ImperialSpaceSociety/Cansat-2020-team-1/README.md

# Cansat-2020-team-1
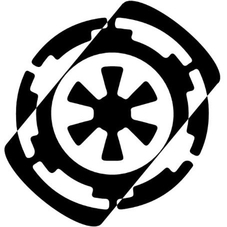
[picture p1: Media/team image.jpg]
Team_Logo

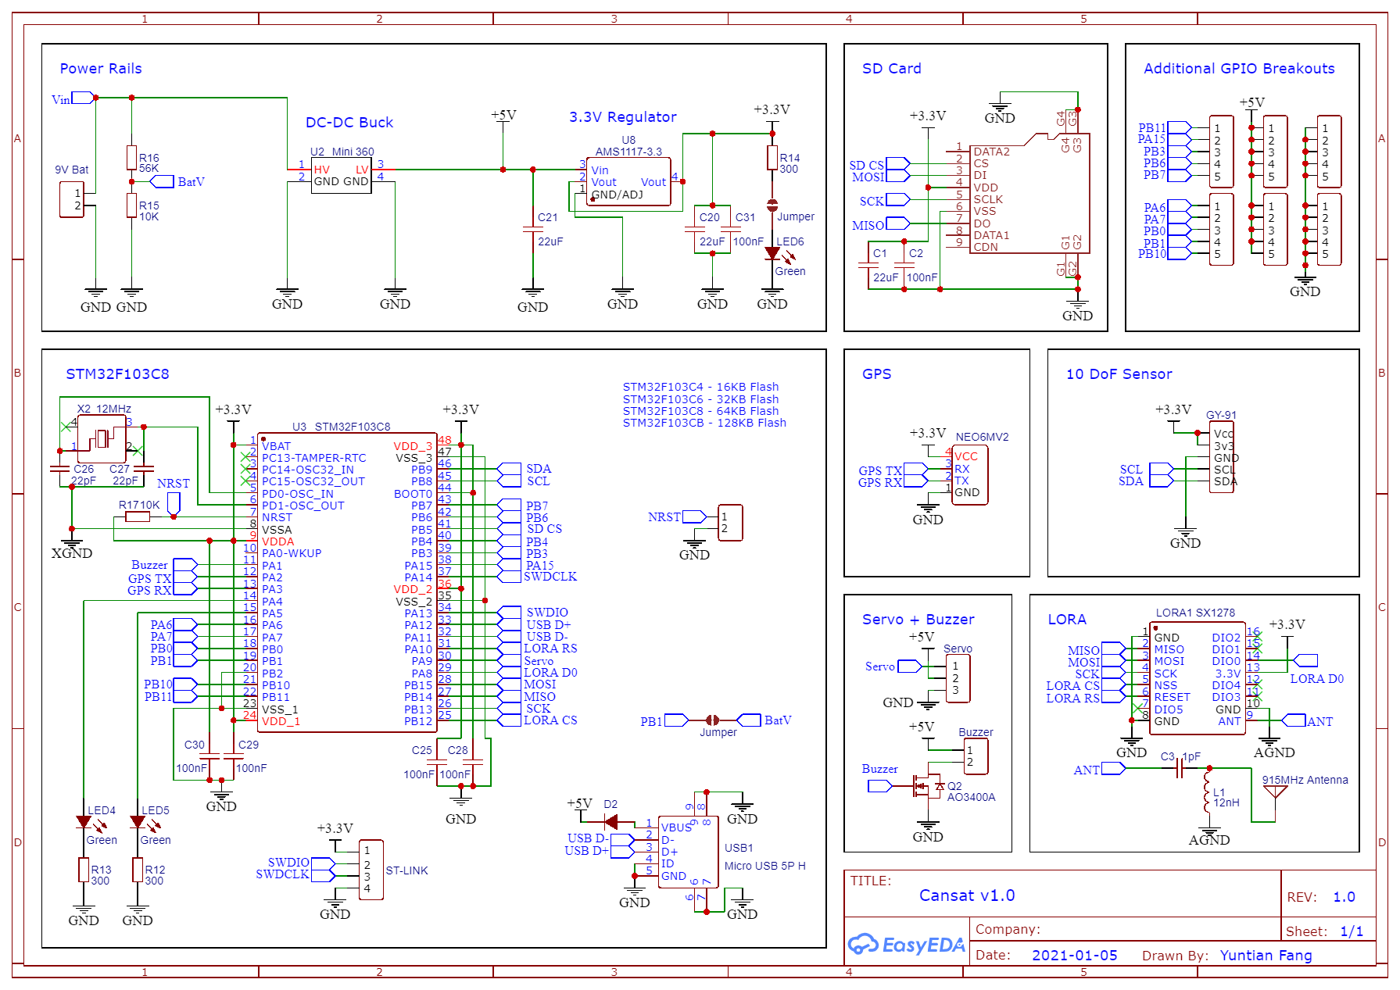
[picture p2: Cansat PCB Files/Cansat Controller.png]
Cansat_Controller_Schematic

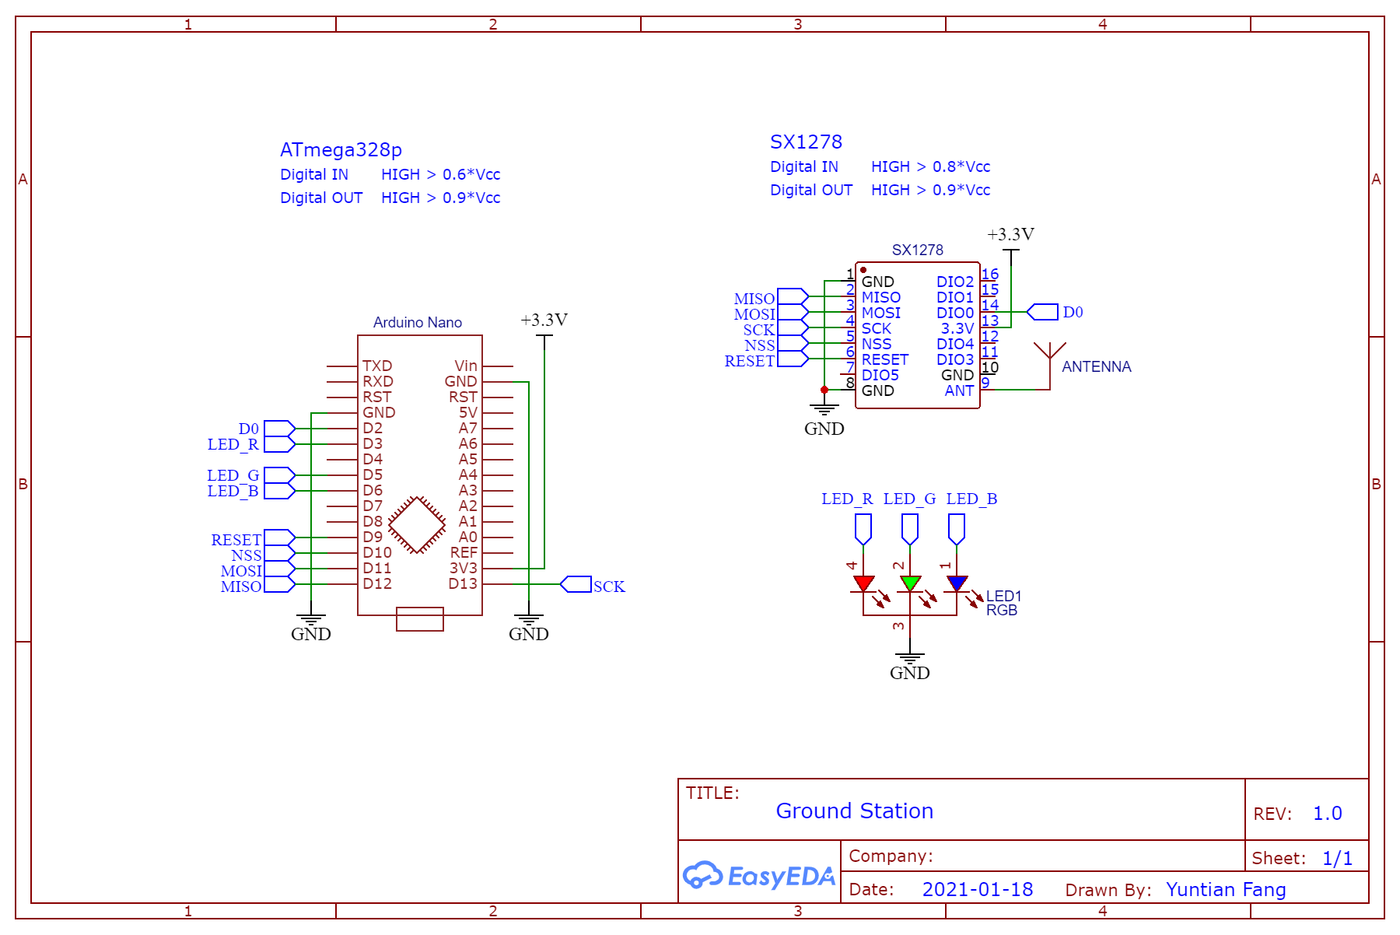
[picture p3: Cansat PCB Files/Ground station.png]
Ground_Station_Schematic


EasyEDA project can be found at:
https://oshwlab.com/tfang15532/2020-cansat
