ImperialSpaceSociety/Cansat-2020-team-1/Cansat PCB Files/PCB Back.png

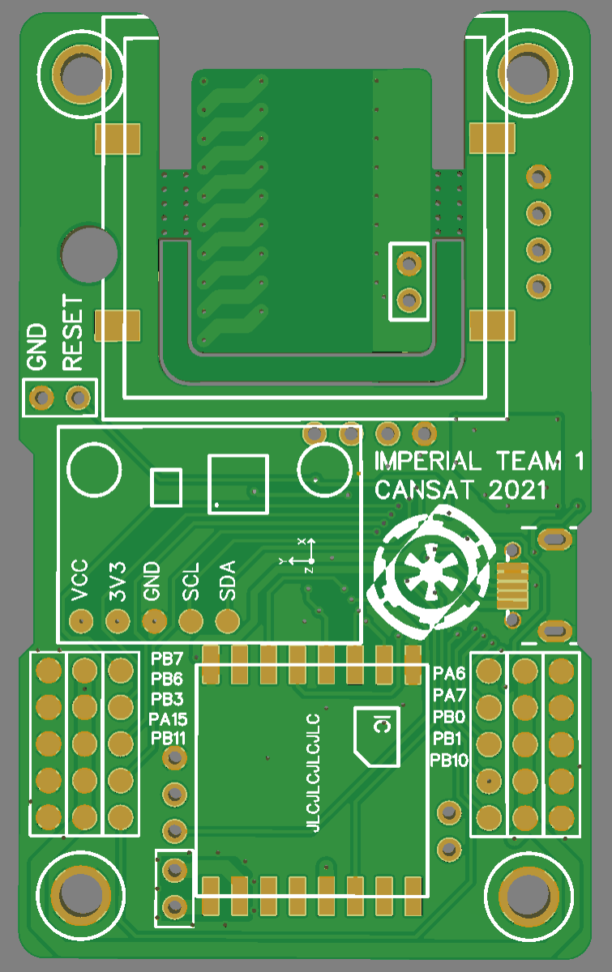
Cansat PCB Files/PCB Back.png
