ImperialSpaceSociety/Cansat-2020-team-1/Cansat PCB Files/PCB Front.png

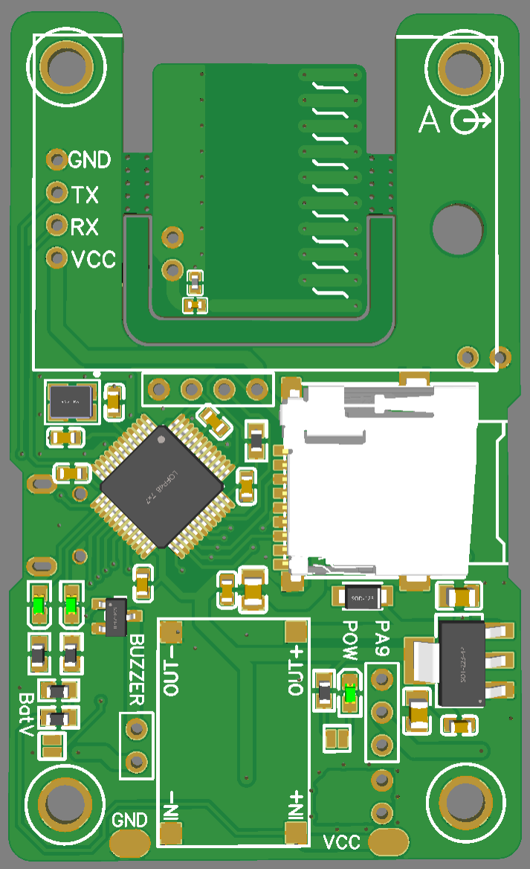
Cansat PCB Files/PCB Front.png
