ImperialSpaceSociety/Cansat-2020-team-1/Media/CanSat Code.png

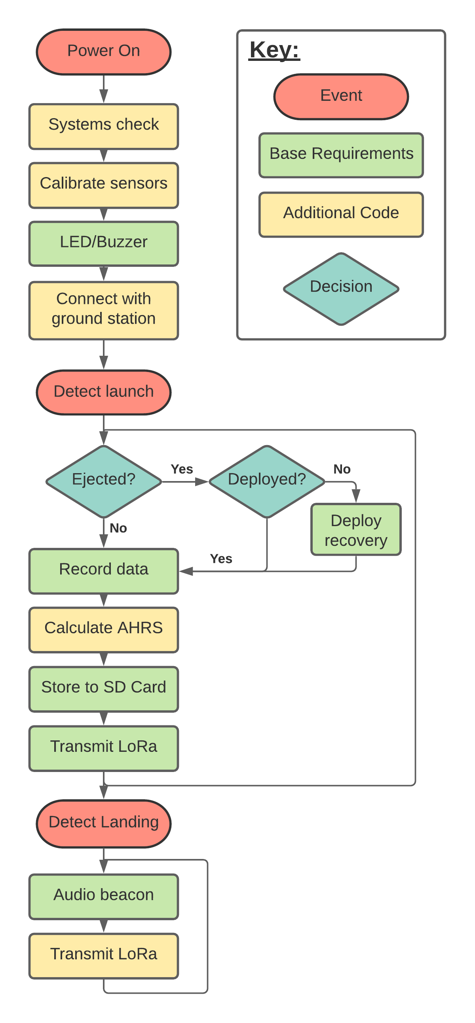
Media/CanSat Code.png
