ImperialSpaceSociety/Cansat-2020-team-1/Media/Cansat Power.png

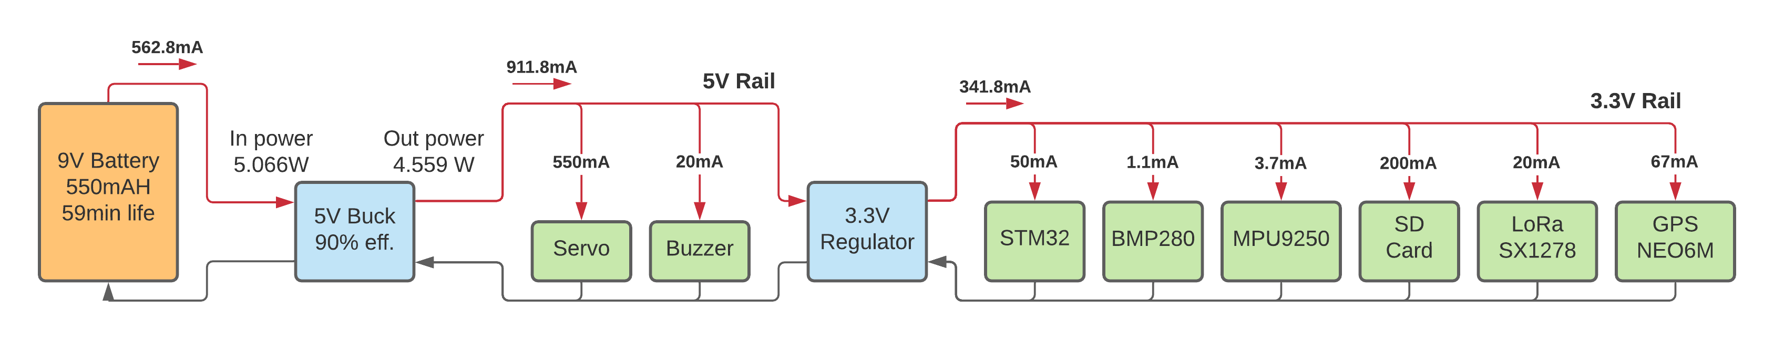
Media/Cansat Power.png
