ImperialSpaceSociety/Cansat-2020-team-1/Media/Madgwick Filter.png

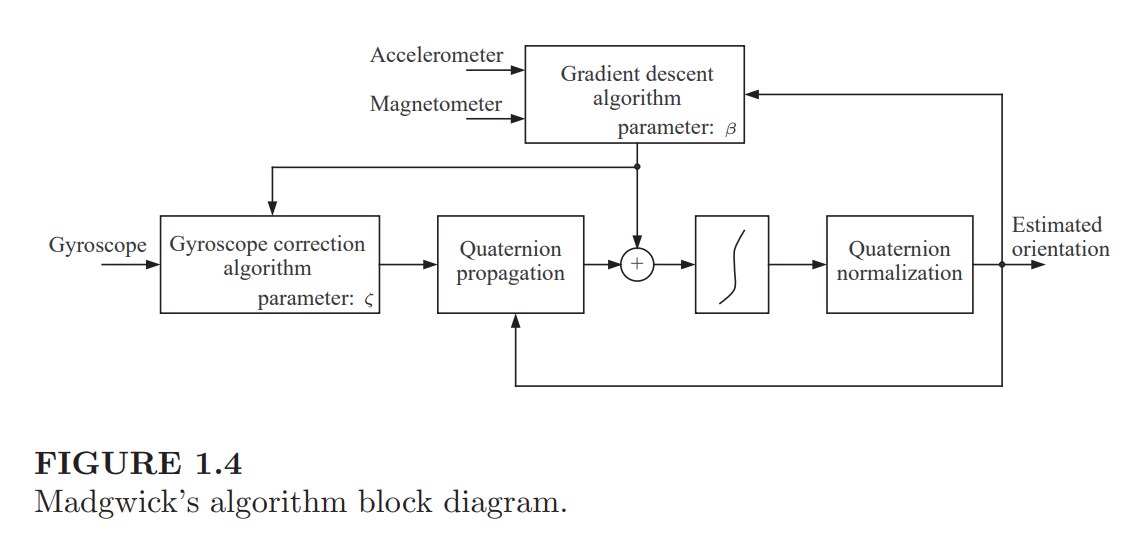
Media/Madgwick Filter.png
