ImperialSpaceSociety/Cansat-2020-team-1/Media/Mahony Filter.png

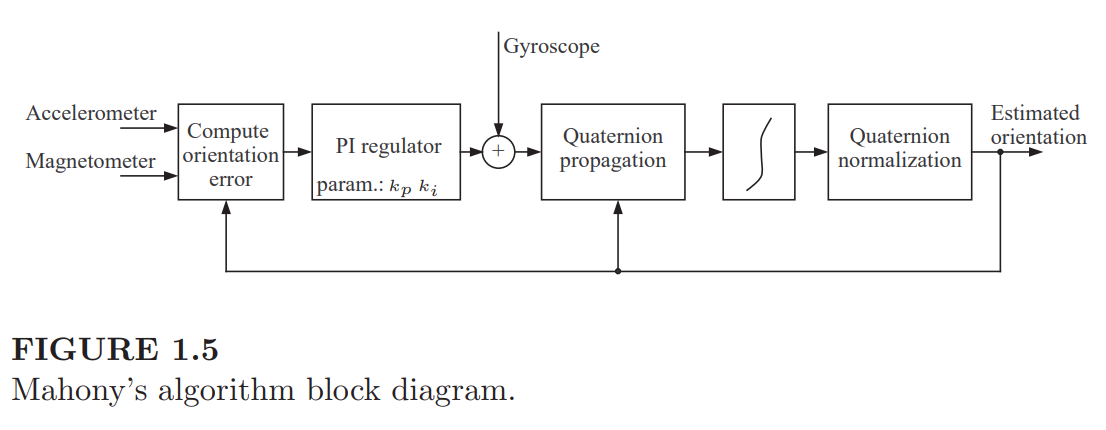
Media/Mahony Filter.png
