ImperialSpaceSociety/Cansat-2020-team-1/Cansat PCB Files/BOM_ICLR - Cansat Controller 2021_2021-01-20.csv

ID | Name | Designator | Footprint | Quantity | Manufacturer Part | Manufacturer | Supplier | Supplier Part | JLCPCB SMD | LCSC Assembly
1 | 22pF | C26,C27 | C0603 | 2 | CL10C220JB8NNNC | SAMSUNG | LCSC | C1653 | Yes
2 | Micro usb | U1 | MICRO USB | 1
3 | 12MHz | X2 | OSC-SMD_4P-L3.2-W2.5-BL | 1 | X322512MSB4SI | YXC | LCSC | C9002 | Yes
4 | Mini 360 | U2 | MINI 360 | 1
5 | 22uF | C20,C21,C1 | C0805 | 3 | CL21A226MAQNNNE | SAMSUNG | LCSC | C45783 | Yes
6 | 12nH | L1 | L0402 | 1 | SDCL1005C12NJTDF | Sunlord | LCSC | C24563 | Yes | Yes
7 | SX1278 | LORA1 | SX1278 | 1 |  |  | eBay
8 | 100nF | C25,C28,C29,C30,C31,C2 | C0603 | 6 | CC0603KRX7R9BB104 | YAGEO | LCSC | C14663 | Yes
9 | Green | LED4,LED5,LED6 | LED0603-R-RD | 3 | 19-217/GHC-YR1S2/3T | EVERLIGHT | LCSC | C72043 | Yes
10 | 56K | R16 | R0603 | 1 | 0603WAF5602T5E | UniOhm | LCSC | C23206 | Yes
11 | AMS1117-3.3 | U8 | SOT-223-3_L6.5-W3.4-P2.30-LS7.0-BR | 1 | AMS1117-3.3 | AMS | LCSC | C6186 | Yes
12 | STM32F103C8 | U3 | LQFP-48_L7.0-W7.0-P0.50-LS9.0-BL | 1 | STM32F103CBT6 | STMicroelectronics | LCSC | C8304
13 | ANTENNA | ANT1 | ANTENNA | 1
14 | Micro SD Card Holder; | J1 | SD CARD | 1 | ?
15 | Jumper | SJ2,SJ1 | PAD-JUMPER-2-NO_NO_SILK | 2
16 | HDR-M-2.54_1x5 | J2,J3,J4,J5,J6,J7 | HDR-M-2.54_1X5 | 6 |  |  | LCSC | C358687
17 | HDR-M-2.54_1x5 | GY-91 | GY-91 MODIFIED | 1 |  |  | LCSC | C358687
18 | 10K | R15,R17 | R0603 | 2 | 0603WAF1002T5E | UniOhm | LCSC | C25804 | Yes
19 | 300 | R12,R13,R14 | R0603 | 3 | 0603WAF3000T5E | UniOhm | LCSC | C23025 | Yes
20 | NEO6MV2 | U9 | GY-NEO6MV2 | 1 |  |  | eBay
21 | 1pF | C3 | C0402 | 1 | 0402CG1R0C500NT | FH | LCSC | C1550 | Yes | Yes
22 | B5819W_C8598 | D2 | SOD-123_L2.8-W1.8-LS3.7-RD | 1 | B5819W | CJ | LCSC | C8598 | Yes
23 | AO3400A | Q2 | SOT-23-3_L2.9-W1.6-P1.90-LS2.8-BR | 1 | AO3400A | AOS | LCSC | C20917 | Yes
