ImperialSpaceSociety/Cansat-2020-team-1/Media/Data Handling.xlsx

Sheet: Signal Strength
f/MHz | 868 | datasheet: | https://cdn-shop.adafruit.com/product-files/3179/sx1276_77_78_79.pdf
 |  |  | Path loss
 | TX Strength | Antenna (worst case) | 0 | 20 | 40 | 60 | 80 | 100 | 120 | 140 | 160 | 180 | 200 | 220 | 240 | 260 | 280 | 300 | 320 | 340 | 360 | 380 | 400 | Antenna | RX
dB change |  | -12 | 0 | 57.24099442 | 63.26159433 | 66.78341951 | 69.28219424 | 71.2203945 | 72.80401942 | 74.14295522 | 75.30279416 | 76.32584461 | 77.24099442 | 78.06884812 | 78.82461934 | 79.51986146 | 80.16355513 | 80.7628196 | 81.32339407 | 81.84997284 | 82.34644452 | 82.81606644 | 83.26159433 | -6
Signal dB Strength | 7 | -5 | -5 | -62.24099442 | -68.26159433 | -71.78341951 | -74.28219424 | -76.2203945 | -77.80401942 | -79.14295522 | -80.30279416 | -81.32584461 | -82.24099442 | -83.06884812 | -83.82461934 | -84.51986146 | -85.16355513 | -85.7628196 | -86.32339407 | -86.84997284 | -87.34644452 | -87.81606644 | -88.26159433 | -94.26159433 | -94.26159433
RX Sensitivity Minimum | -118.5103 | -118.5103 | -118.5103 | -118.5103 | -118.5103 | -118.5103 | -118.5103 | -118.5103 | -118.5103 | -118.5103 | -118.5103 | -118.5103 | -118.5103 | -118.5103 | -118.5103 | -118.5103 | -118.5103 | -118.5103 | -118.5103 | -118.5103 | -118.5103 | -118.5103 | -118.5103 | -118.5103 | -118.5103
LoRa RX Sensitivity
Spreading Factor (SNR): | 7
Noise Floor/dB | 6
Bandwidth/Hz | 500000
RX Sens. | -118.5
LoRa Data Rate
Spreading Factor | 7
Bandwidth/Hz | 500000
Code Rate (4:5 means 1) | 1
Data rate/bits per s | 21875
Data rate/bytes per s | 2734.375
Payload/bytes | 59
Header: 0=on | 0
Low Data Rate Optimisaion: 1=on | 0
Total Message Payload/bytes | 98
Duty Cycle | 0.1
Data packet rate/packets per s | 2.79
lora packet size equation p7 of: | https://www.rs-online.com/designspark/rel-assets/ds-assets/uploads/knowledge-items/application-notes-for-the-internet-of-things/LoRa%20Design%20Guide.pdf

Sheet: Our Data Packet
 | Base requirements |  |  |  |  |  |  |  |  | Bonus
Name | Packet count | Mission time | Pressure | Temperature | Altitude | Battery V | GPS Long. | GPS Lat. | Soft state | GPS Alt. | Pitch | Yaw | Roll | Acc X | Acc Y | Acc Z
Type | uint16_t | uint32_t | float | float | float | float | float | float | uint8_t | float | float | float | float | float | float | float
Units |  | ms | Pa | C | m | mV |  |  |  | m | deg | deg | deg | ms-2 | ms-2 | ms-2
 | Total length: | 59 | Bytes
 |  | 472 | Bits
