ImperialSpaceSociety/Cansat-2020-team-1/Media/Magnetometer calibration.png

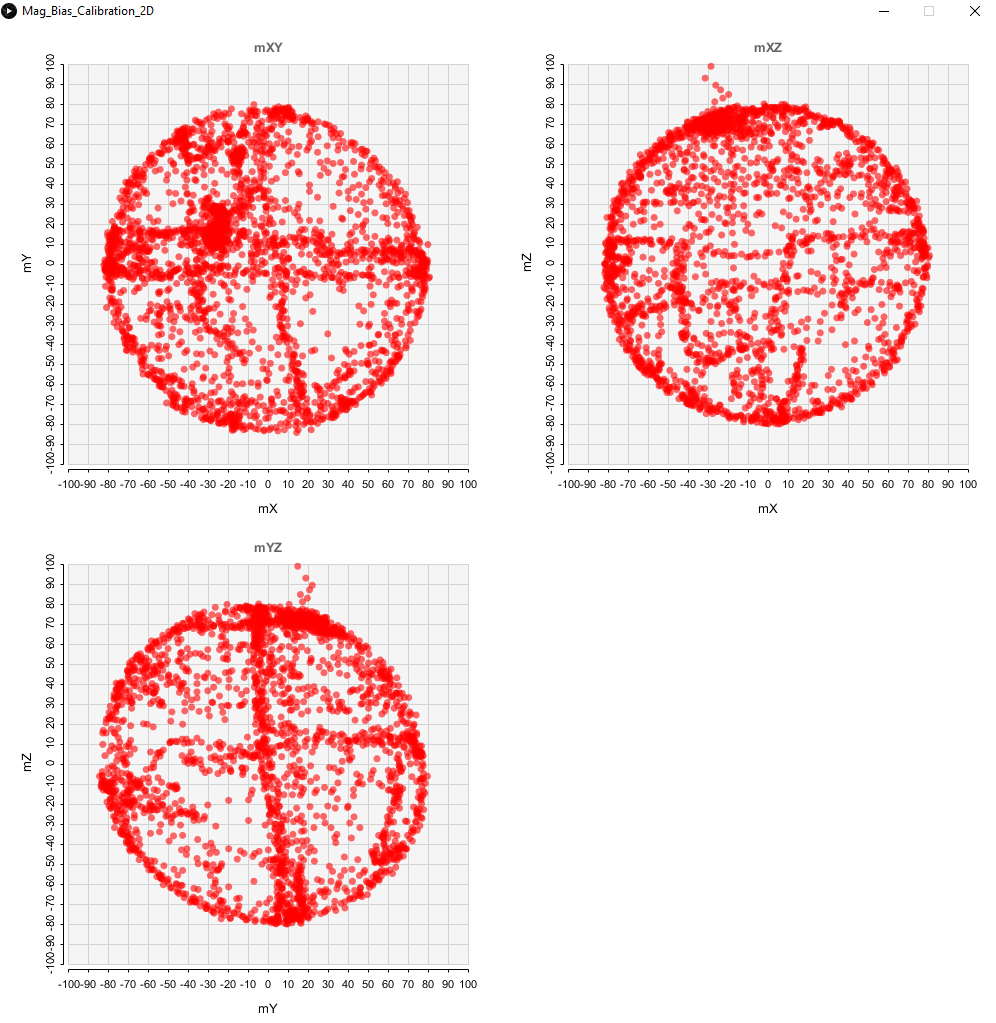
Media/Magnetometer calibration.png
