ImperialSpaceSociety/Cansat-2020-team-1/(commit log)

2021-01-20 add code and datasheets
    [MPU9250 I2C Read Timing.xlsx, PCB Cost.xlsx]
2021-01-20 added folders
    [MPU9250 I2C Read Timing.xlsx, PCB Cost.xlsx]
2021-01-20 added lora antenna and renamed some things
    [LORA Link Budget Calculator.xlsx]
2021-01-20 Added PCB Files
    [BOM_ICLR - Cansat Controller 2021_2021-01-20.csv, LORA Link Budget Calculator.xlsx, MPU9250 I2C Read Timing.xlsx, PCB Cost.xlsx, PickAndPlace_Cansat Controller PCB v1.1_2021-01-20.csv]
2021-01-22 added magnetometer calibration things
    [Data Handling.xlsx, LORA Link Budget Calculator.xlsx]
